ethanyang2000/MaskDetectRobot/pics/robot.png

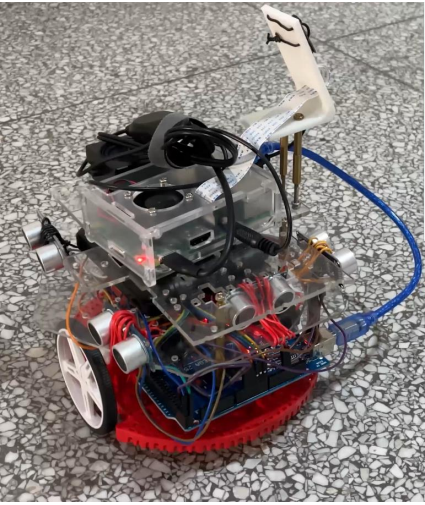
pics/robot.png
