ethanyang2000/MaskDetectRobot/pics/arch.png

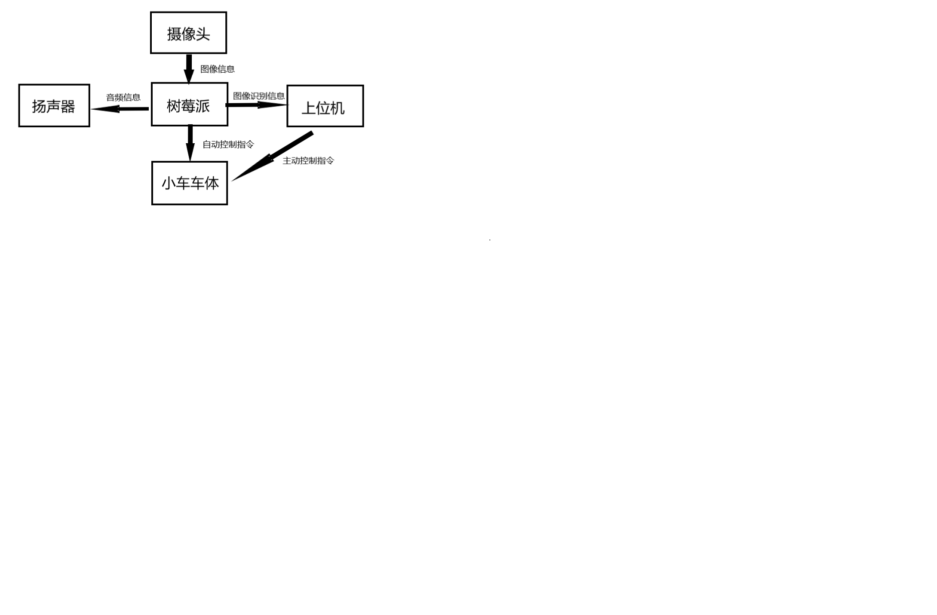
pics/arch.png
